yupipi93/arduino-oscilloscope-PG240128-A/(commit log)

2026-07-16 Research docs and for-dummies hello-world guide for the Nano scope
    Internet research (existing Arduino oscilloscope projects, ATmega328P
    ADC capabilities, analog front-end and trigger design) condensed into
    docs/, plus a beginner step-by-step wiring guide that gets a hello
    world on the PG240128-A with an oscilloscope-ready pin map, and the
    milestone build plan (M0-M6).
2026-07-16 Add generated wiring diagram for the Nano hello world
    PIL-based generator (technique from multi-rocket-avionica's
    breadboard-wiring/wiring_diagram.py): color-coded bundles for data,
    control, power rails, contrast pot and backlight, embedded in the
    hello-world guide and README.
2026-07-17 M0 firmware: hello world sketch, verified on real hardware
    Compiled (12050 B flash / 752 B RAM) and uploaded to a Nano clone
    (CH340, old bootloader) with arduino-cli.
2026-07-17 M1 firmware: static waveform viewer
    Capture-then-draw: 240 analogRead samples from A7 (one per column,
    ~9.6 kSps), drawn as connected lines in the U8g2 page loop. Test
    signal: Nano's own PWM on D3 through the 10k front-end resistor.
    No trigger yet (M2). 8064 B flash / 916 B RAM.
2026-07-17 One wiring diagram per milestone (M0-M6), embedded in the build plan
    Parametric generator (tools/wiring_diagrams.py, replaces
    wiring_hello_world.py) draws the M0 base scene and layers each
    milestone's hardware: M1 test signal, M4 buttons, M5 front-end +
    CAL post + RANGE sense, M6 second channel. Software-only milestones
    (M2/M3) get an explicit "no new wiring" banner.
2026-07-17 M1 verified on hardware; M2 firmware: software edge trigger
    M1 confirmed with photos: 13 square-wave cycles as calculated, plus
    50 Hz mains hum via finger test. Ghosting diagnosed: untriggered
    drift on a slow STN panel. M2 (triggered_viewer) adds poll-then-
    capture rising-edge trigger, +/-4 count hysteresis, 250 ms auto
    free-run, trigger marker and TRIG/FREE readout. Uploaded to the Nano.
    [triggered_viewer.ino]
2026-07-17 M2 verified on hardware; M3 firmware: free-running ADC time base
    M2 confirmed: wave locked, ghosting gone with the stable trace.
    M3 (fast_sampler): register-level free-running ADC with ADLAR,
    10-tier time base (1.6 ms - 1.2 s per screen; prescaler bursts +
    micros()-paced slow tiers), serial +/- tier control until M4
    buttons. Uploaded to the Nano.
2026-07-17 Design fix: HOLD button D13 -> D12, RANGE sense D12 -> A4
    The Nano's onboard LED on D13 forms a divider against the internal
    pull-up (~1.9 V, reads LOW forever), so D13 cannot be a button input.
    HOLD moves to D12; the M5 range-sense moves to A4. Diagrams
    regenerated, docs and pin-budget table updated.
2026-07-17 Component list to finish the project (docs/06-components.md)
    Every part needed for M4-M6, detailed: exact spec, circuit role,
    substitutes, why 1% resistors matter, film-vs-electrolytic, D13
    caveat context, plus a consolidated buy list (~3 EUR mandatory,
    ~18 EUR with probe and options).
2026-07-17 M3 verified; M4 firmware: buttons, graticule, Vpp/freq panel
    M4 (scope_ui): 200-px waveform + readout panel (time base, trigger
    mode AUTO/NORM/ONE, state, Vpp, frequency), dotted graticule,
    SELECT (D2) short/long press, HOLD (D12) freeze/re-arm, abortable
    trigger wait so the UI stays responsive. Works with no buttons
    wired. Explicit pollBtn prototype dodges the .ino preprocessor
    hoisting bug. Uploaded to the Nano.
    [scope_ui.ino]
2026-07-17 Components: specify threaded-bushing KY-040 for panel mounting
2026-07-20 M4 UX: zoom in on HOLD short press, freeze moves to HOLD long press
    SELECT short = slower (zoom out), HOLD short = faster (zoom in),
    SELECT long = trigger mode, HOLD long = freeze/re-arm. Both time-base
    directions now reachable without cycling through all 10 tiers.
    [scope_ui.ino]
2026-07-20 Scope-style button naming: SEC/DIV +/- with RUN/STOP and TRIG MODE
    Diagrams M4+ show the primary function on each button and the
    long-press secondary in small text, with a short/long legend.
    Firmware comments and pin defines renamed to match; on-screen
    frozen state now reads STOP (RUN/STOP convention). Uploaded.
    [scope_ui.ino]
2026-07-20 M4: vertical auto-scale so any amplitude fills the screen
    Each frame maps the captured min..max to y 121..6 (6-px margin), so
    full-swing signals no longer sit on the frame lines and small signals
    zoom to full height. Range clamped to >=0.2 V so DC doesn't amplify
    noise; trigger marker hidden when the level is outside the view;
    "Vauto" indicator on the panel (true amplitude = Vpp readout).
    [scope_ui.ino]
2026-07-20 Build log: M4 verified on hardware (photo, 50 Hz hum, clipping analysis)
2026-07-20 M4.5: bandgap Vcc calibration — Vpp uses real supply millivolts
    readVccmV() measures the internal 1.1 V reference against AVcc
    (10-bit single conversions, averaged, first readings discarded).
    Vcc remeasured every 5 s, shown on a boot splash; BANDGAP_MV
    constant documented for the one-time multimeter refinement.
2026-07-20 Calibrate bandgap constant against multimeter: 1088 mV
    4.73 V (meter) vs 4.78 V (splash) -> this chip's bandgap = 1.088 V.
    Voltage readings now ~1% accurate.
2026-07-20 README: signal-chain tagline as the project's lead
